arsalansabet/Gas-Sensor/Code/FINAL/README

This is the final code with SSID and password

TX Fix from https://github.com/esp8266/Arduino/issues/3100
