arsalansabet/Gas-Sensor/Process Documentation/NodeMCU_1.0 Setup.docx

This is the github repository where the libraries and example code can be found, ESP Modules are explained here:

https://github.com/esp8266/Arduino/blob/209c87715768b0f280bb85b3832883487dc4d2e9/doc/boards.md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

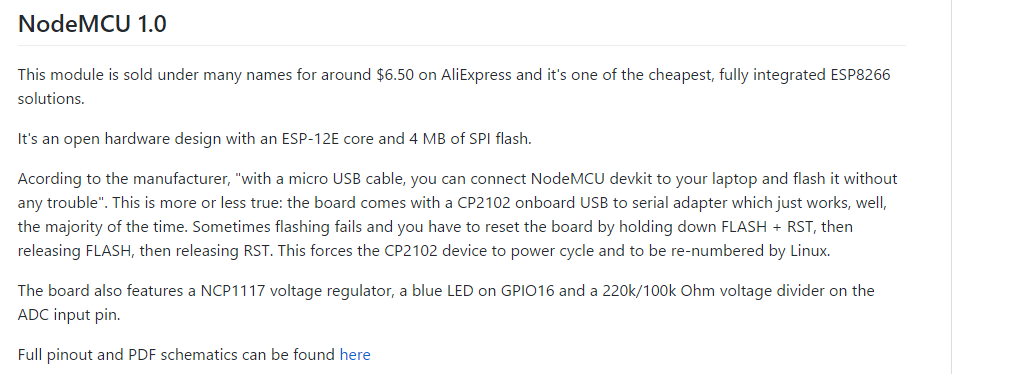
[picture p4: figure]

See pinout and other stuff about the NodeMCU 1.0 here:

https://github.com/nodemcu/nodemcu-devkit-v1.0

# Board Setup - https://github.com/esp8266/Arduino

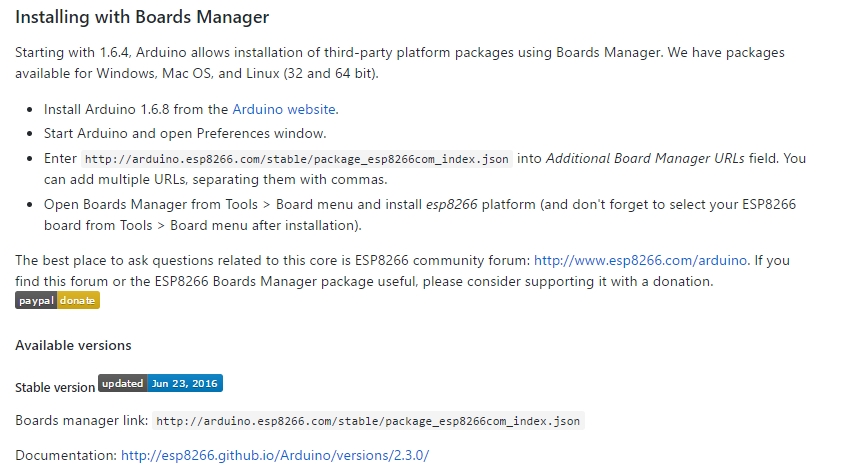
[picture p5: figure]

Here’s the link from above that you need to paste http://arduino.esp8266.com/stable/package_esp8266com_index.json

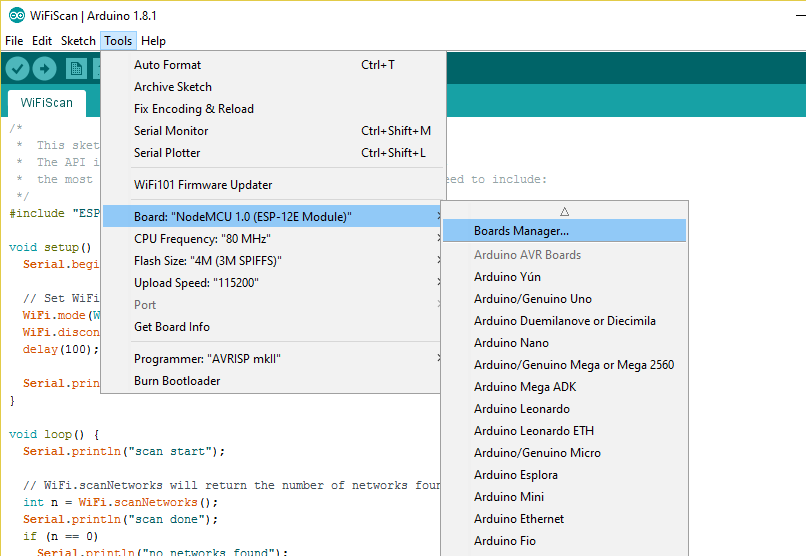
[picture p6: figure]

Install 2.3

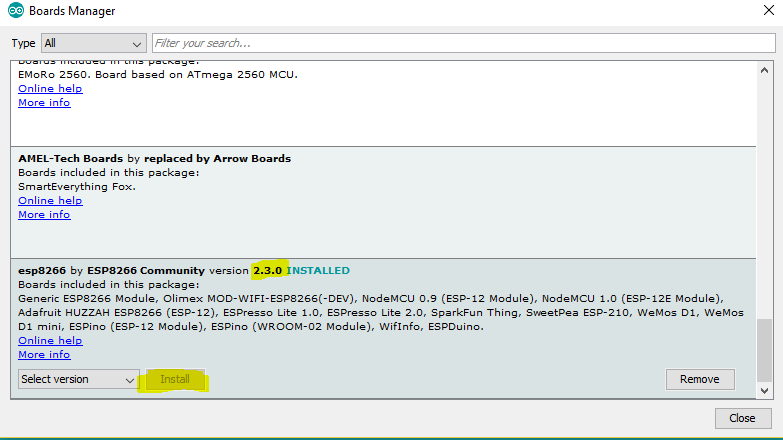
[picture p7: figure]

# Library Setup

- Clone github: https://github.com/esp8266/Arduino

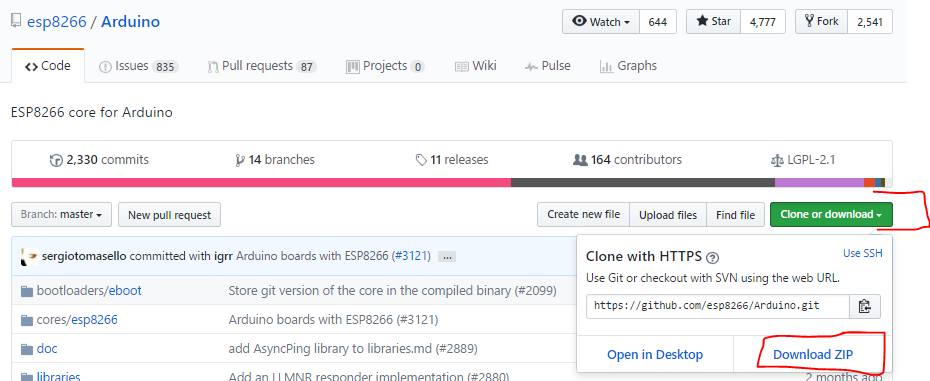
[picture p8: figure]

- Go unzip the file!
- Go to folder “\Arduino-master\Arduino-master\libraries\” and copy and zip the folder “ESP8266WiFi” to your preferred location
- Add the zipped library in the Arduino IDE:

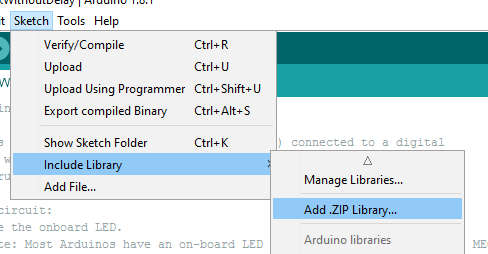
[picture p9: figure]

# Upload a sketch

1. Open file e.g. “WiFiAccessPoint_v0.1” from https://github.com/arsalansabet/Gas-Sensor/tree/master/Code/Test%20Code
  a. And select the NodeMCU 1.0… as your board
  b. Make sure the programmer is “AVRISP mkII”
  c. Open the serial monitor to see printin statements from the ESP
  d. Select the proper port, this will vary from PC to PC. Ports are shown as “COMx”

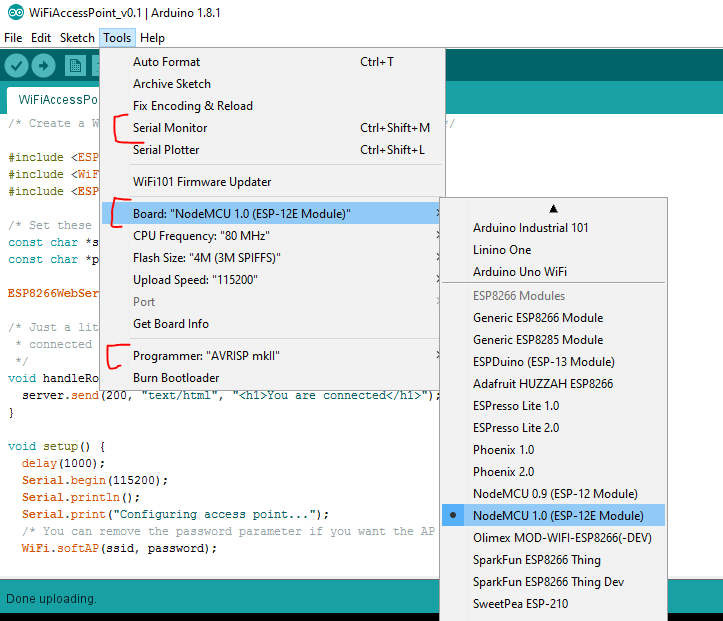
[picture p10: figure]
