arsalansabet/Gas-Sensor/Process Documentation/Setup SoftAP.docx

Clone github: https://github.com/esp8266/Arduino

Unzip. Go to folder “\Arduino-master\Arduino-master\libraries\” and copy and zip the folder “ESP8266WiFi” to your preferred location

Add the zipped library:

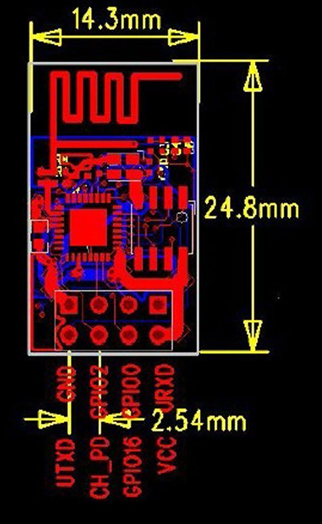
[picture p11: figure]

Pinout descriptions for different models

http://www.esp8266.com/wiki/doku.php?id=esp8266-module-family#esp-01

This section give schematics and how to set up (see images below)

https://github.com/esp8266/Arduino/blob/master/doc/boards.md

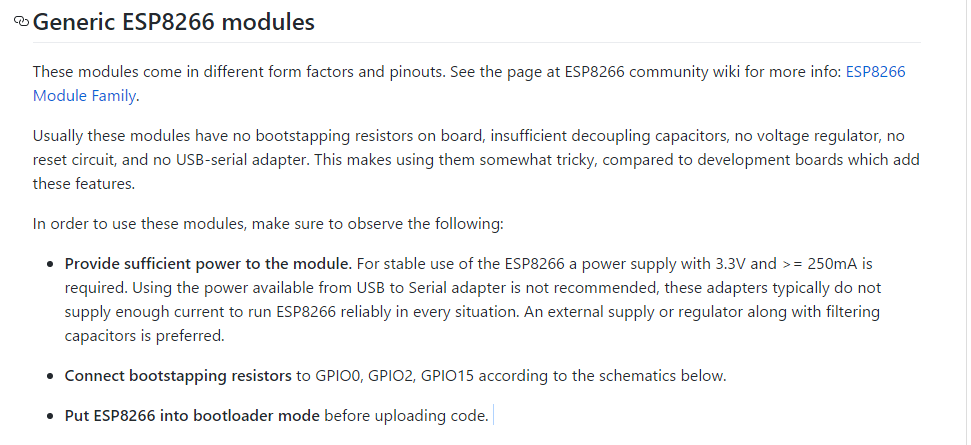
[picture p12: figure]

Set the FTDI232 USB converter to 3.3V!!!!

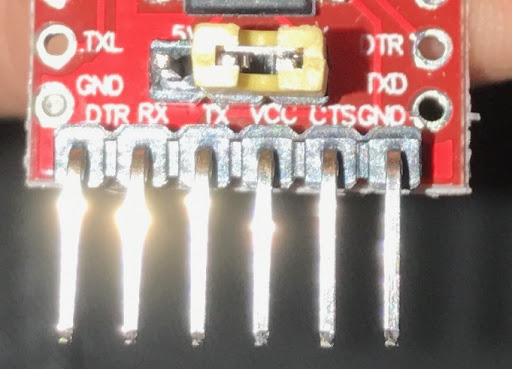
[picture p13: figure]
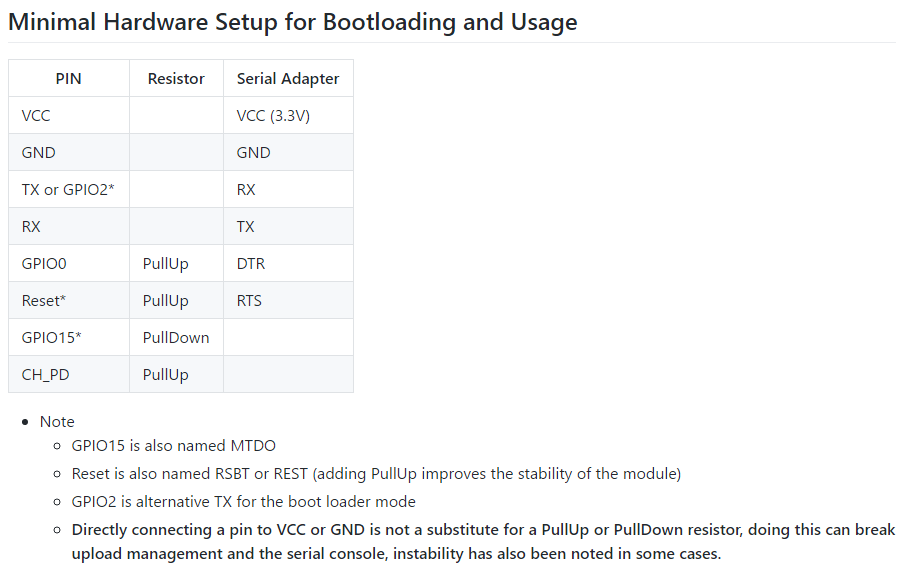
[picture p14: figure]
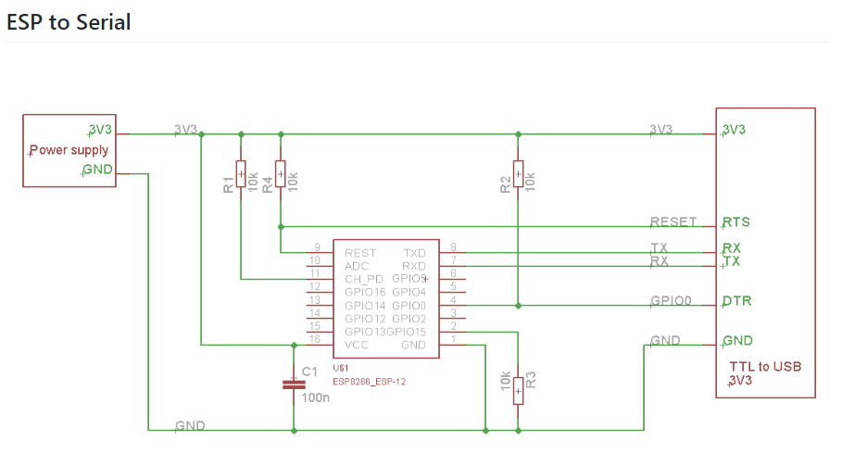
[picture p15: figure]

Then go here and here for example code:

https://github.com/esp8266/Arduino/blob/master/doc/esp8266wifi/readme.md#soft-access-point

https://github.com/esp8266/Arduino/blob/master/doc/esp8266wifi/soft-access-point-class.md

Troubleshooting

https://github.com/esp8266/Arduino/blob/209c87715768b0f280bb85b3832883487dc4d2e9/doc/faq/a01-espcomm_sync-failed.md
