arsalansabet/Gas-Sensor/Schematic and Layout/Tx.brd

## EAGLE design Schematic and Layout/Tx.brd (2017-05-27)

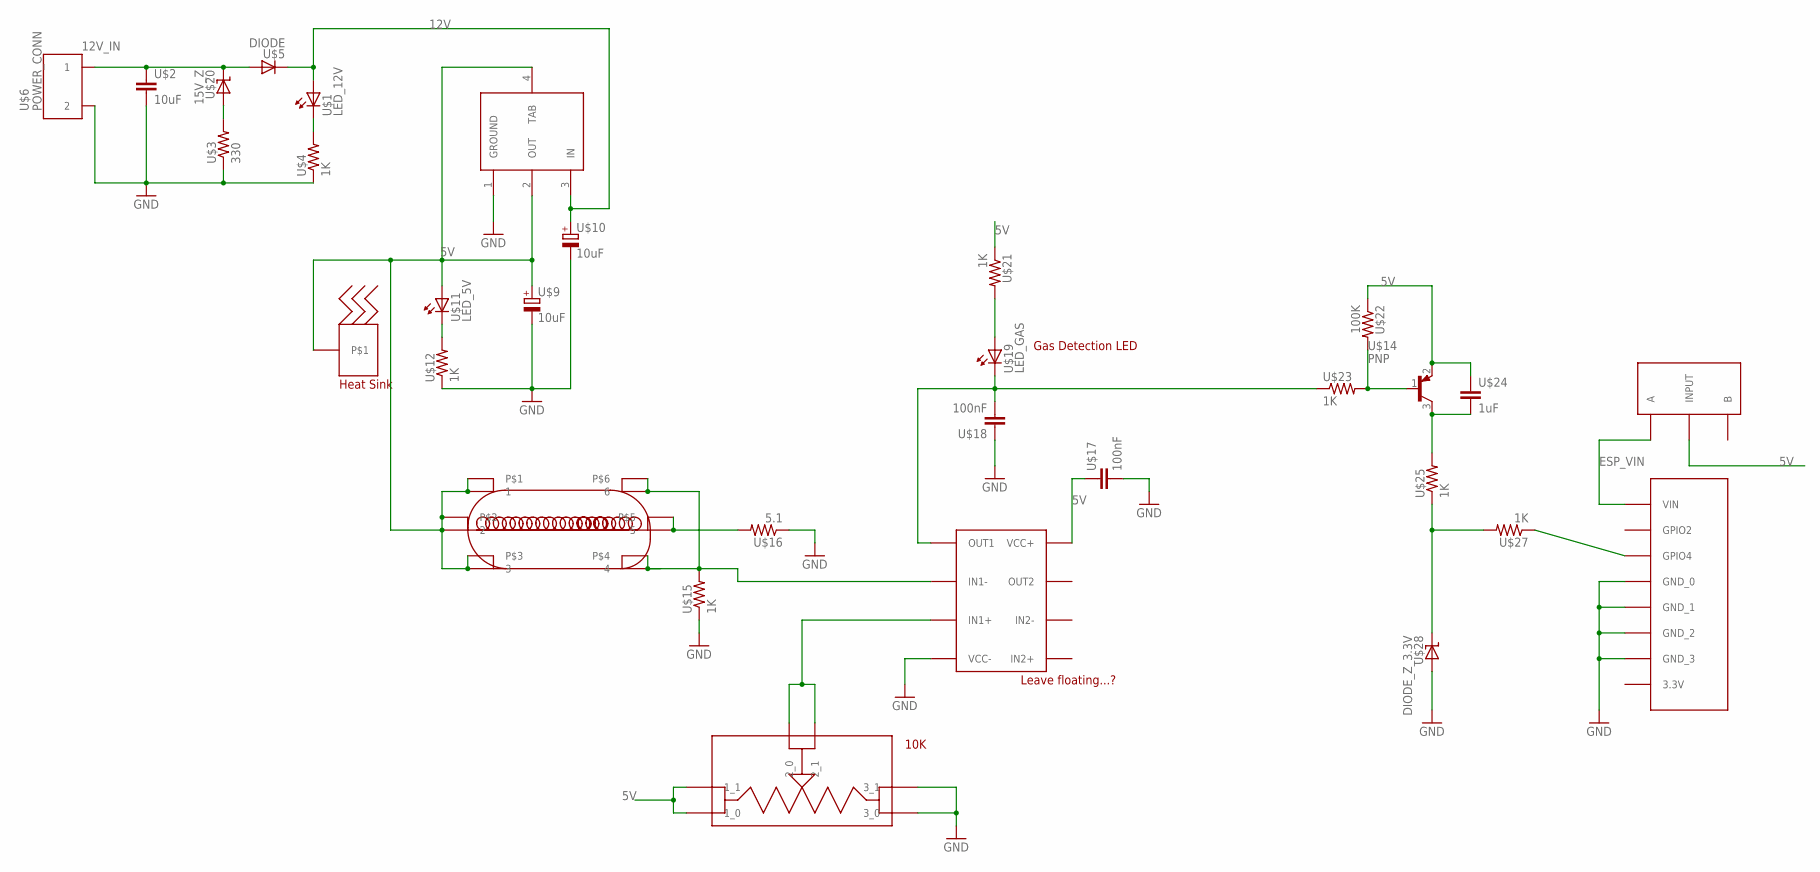
[picture p16: schematic Tx.sch]

Parts:
U$1: LED_12V; LED_1206
U$2: 10uF; C1206
U$3: 330; R1206
U$4, U$12, U$15, U$21, U$23, U$25, U$27: 1K; R1206
U$5: DIODE; DIDOE_1206
U$6: POWER_CONN; PC_1935161
U$7: LM393; SO8
U$8: 5V_REG; SOT223
U$9, U$10: 10uF; 153CLV-0405
U$11: LED_5V; LED_1206
U$13: MQ; MQ_GAS
U$14: PNP; SOT23
U$16: 5.1; R1206
U$17, U$18: 100nF; C1206
U$19: LED_GAS; LED_1206
U$20: 15V_Z; Z_1005
U$22: 100K; R1206
U$24: 1uF; C1206
U$28: DIODE_Z_3.3V; SOD-323
U$29: ESP8266; ESP
U$30: POTENTIOMETER
U$31: HEAT_SINK; THERMAL
U$32: SPDT

Connections:
5V: U$7.8 (VCC+), U$8.2 (OUT), U$8.4 (TAB), U$9.+, U$11.1 (HI), U$13.1, U$13.2, U$13.3, U$13.7, U$13.8, U$13.9, U$14.2 (E), U$17.1, U$21.1, U$22.1, U$24.1, U$30.1_0, U$30.1_1, U$31.P$1, U$32.IN (INPUT)
12V: U$1.1 (HI), U$5.2 (LO), U$8.3 (IN), U$10.+
12V_IN: U$2.1, U$5.1 (HI), U$6.1, U$20.2 (LO)
ESP_VIN: U$29.VIN, U$32.A
GND: U$2.2, U$3.1, U$4.1, U$6.2, U$7.4 (VCC-), U$8.1 (GROUND), U$9.-, U$10.-, U$12.1, U$15.1, U$16.1, U$17.2, U$18.1, U$28.P$1 (HI), U$29.GND_0, U$29.GND_1, U$29.GND_2, U$29.GND_3, U$30.3_0, U$30.3_1
unnamed: U$1.2 (LO), U$4.2
unnamed: U$11.2 (LO), U$12.2
unnamed: U$13.5, U$13.11, U$16.2
unnamed: U$3.2, U$20.1 (HI)
unnamed: U$7.3 (IN1+), U$30.2_0, U$30.2_1
unnamed: U$7.1 (OUT1), U$18.2, U$19.2 (LO), U$23.1
unnamed: U$14.1 (B), U$22.2, U$23.2
unnamed: U$19.1 (HI), U$21.2
unnamed: U$14.3 (C), U$24.2, U$25.2
unnamed: U$25.1, U$27.2, U$28.P$2 (LO)
unnamed: U$27.1, U$29.GPIO4
unnamed: U$7.2 (IN1-), U$13.4, U$13.6, U$13.10, U$13.12, U$15.2

Notes on the sheet:
Leave floating...?
Gas Detection LED
10K

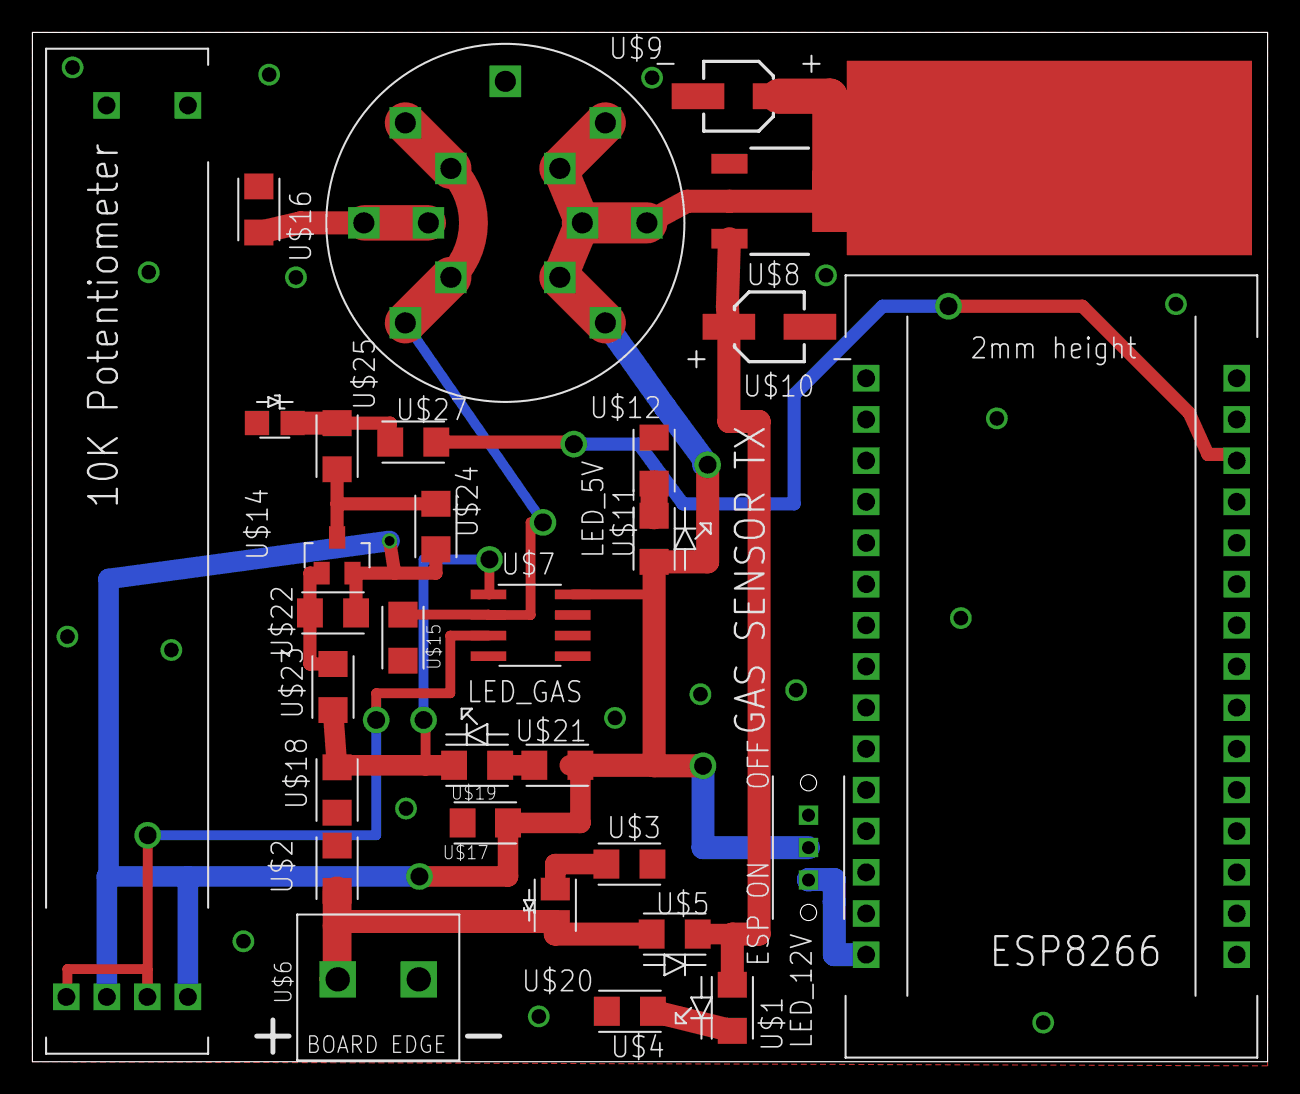
[picture p17: board Tx.brd from above]

Board: 2 copper layers, 76.2 x 63.5 mm, 31 parts (0 on the bottom side), 17 nets.
