arsalansabet/Gas-Sensor/Schematic and Layout/Rx.brd

## EAGLE design Schematic and Layout/Rx.brd (2017-05-27)

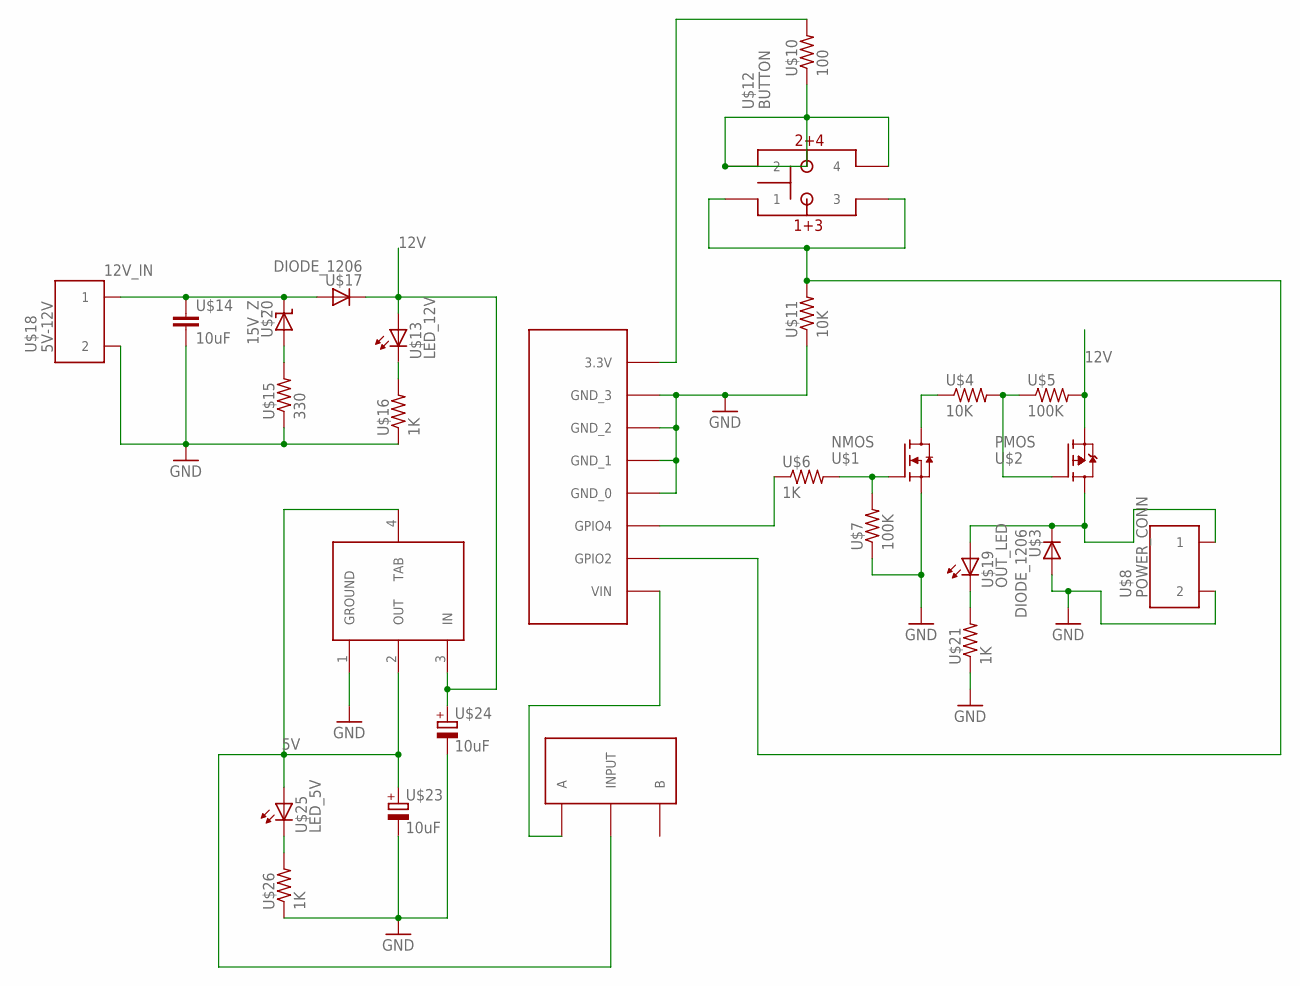
[picture p18: schematic Rx.sch]

Parts:
U$1: NMOS; SOT23
U$2: PMOS; D-PAK_TO252AA
U$3, U$17: DIODE_1206; DIDOE_1206
U$4, U$11: 10K; R1206
U$5, U$7: 100K; R1206
U$6, U$16, U$21, U$26: 1K; R1206
U$8: POWER_CONN; PC_1935161
U$9: ESP8266; ESP
U$10: 100; R1206
U$12: BUTTON
U$13: LED_12V; LED_1206
U$14: 10uF; C1206
U$15: 330; R1206
U$18: 5V-12V; PC_1935161
U$19: OUT_LED; LED_1206
U$20: 15V_Z; Z_1005
U$22: 5V_REG; SOT223
U$23, U$24: 10uF; 153CLV-0405
U$25: LED_5V; LED_1206
U$27: SPDT

Connections:
5V: U$22.2 (OUT), U$22.4 (TAB), U$23.+, U$25.1 (HI), U$27.IN (INPUT)
12V: U$2.3 (S), U$5.2, U$13.1 (HI), U$17.2 (LO), U$22.3 (IN), U$24.+
12V_IN: U$14.1, U$17.1 (HI), U$18.1, U$20.2 (LO)
GND: U$1.2 (S), U$3.1 (HI), U$7.1, U$8.2, U$9.GND_0, U$9.GND_1, U$9.GND_2, U$9.GND_3, U$11.1, U$14.2, U$15.1, U$16.1, U$18.2, U$21.1, U$22.1 (GROUND), U$23.-, U$24.-, U$26.1
unnamed: U$1.1 (G), U$6.2, U$7.2
unnamed: U$6.1, U$9.GPIO4
unnamed: U$1.3 (D), U$4.1
unnamed: U$2.1 (G), U$4.2, U$5.1
unnamed: U$19.2 (LO), U$21.2
unnamed: U$2.4 (D), U$3.2 (LO), U$8.1, U$19.1 (HI)
unnamed: U$9.GPIO2, U$11.2, U$12.1, U$12.3
unnamed: U$25.2 (LO), U$26.2
unnamed: U$10.1, U$12.2, U$12.4
unnamed: U$9.3.3_1 (3.3V), U$10.2
unnamed: U$13.2 (LO), U$16.2
unnamed: U$15.2, U$20.1 (HI)
unnamed: U$9.VIN, U$27.A

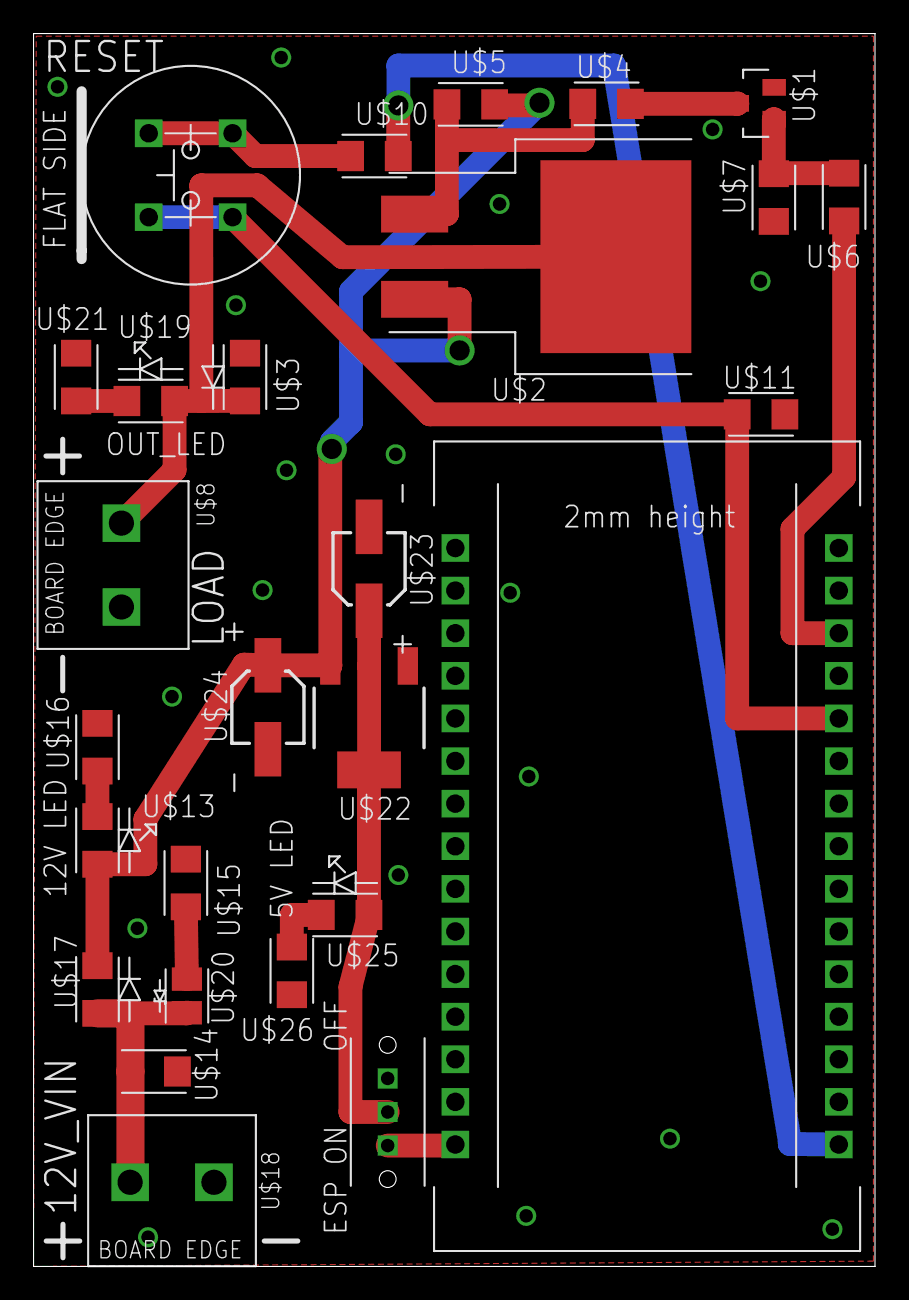
[picture p19: board Rx.brd from above]

Board: 2 copper layers, 50.2 x 73.5 mm, 27 parts (0 on the bottom side), 17 nets.
