arsalansabet/Gas-Sensor/(commit log)

2017-01-13 rudimentary project design
    [_FARTSNIFFER.brd, _FARTSNIFFER.sch]
2017-01-13 catalytic gas sensor
2017-01-31 Very Nice Presentation
    I added a couple of pictures and expanded the frequency range.
    Kam
2017-03-17 Added my initial code for connecting to my hotspot
    Copied code, changed baud rate, ssid, password, and added debugging messages.
    Doesn't work yet, need to fix schematic or try arduino nano
    [my_HelloWorld.ino]
2017-04-16 NodeMCU 1.0 setup walk-through
    Set up my ESP modules with these steps, I was then able to connect two wifi Modules together using the code referenced in https://github.com/arsalansabet/Gas-Sensor/tree/master/Code/Test%20Code
2017-04-17 Added boards manager
    Showed how to add the ESP boards to the arduino IDE
2017-04-20 Added missing steps
    Made more clear, distinguished between library and board setup
2017-04-26 Will blink an LED on GPIO2
2017-04-26 Read and print the status of input GPIO2
2017-04-26 Connect with your laptop and toggle GPIO4 high and low
    This prevents output high during boot! This GPIO must be tied low
    [WiFiAccessPoint_v0.4.ino]
2017-04-29 These will connect and the client will turn on the LED of GPIO4 on the server
2017-04-29 Used GPIO4 on both client and server. If GPIO 4 on client goes high than sensor should be tripped on server at GPIO4.
    Used GPIO4 on both client and server. If GPIO4 on client goes high than
    sensor should be tripped on server at GPIO4.
2017-04-29 Code modified so on start up the sensor won't trip.
2017-05-11 Final BOM
    [BOM and testsV2.xlsx]
2017-05-11 Add files via upload
    I added an output LED on the receiver side and put some silkscreen on the bottom with our first names.
    I also added "RESET" next to the button on the silkscreen for the rx.
    Input capacitance decreased to 10uF. Too expensive to get 470uF.
    [Rx.brd, Rx.sch, Tx.brd, Tx.sch]
2017-05-11 Fixed major error on tx board. Cap overlapped connector
    [Rx.brd, Tx.brd]
2017-05-11 Fixed major error on Tx. Comp overlapped connector
2017-05-11 Minor changes
    [Rx.brd, Tx.brd]
2017-05-11 Major error fixed, was missing 5V on PNP
    [Tx.brd, Tx.sch]
2017-05-11 Added stapled grounds
    [Rx.brd, Tx.brd]
2017-05-11 Added LED indicator silkscreen
    [Rx.brd, Tx.brd]
2017-05-12 Updated project schedule w/ progress for all tasks.
    We are on track!
2017-05-27 ESPs now run off of 5 V
    [Rx.brd, Rx.sch, Tx.brd, Tx.sch]
2017-05-27 Definitively added zener diodes
    [Tx.brd, Tx.sch]
2017-05-28 Updated comment, sounded like device was connecting to a wifi network
